mswietlicki/jaskier_door_lock_ex/hardware/door-lock-c/docs/board-top.png

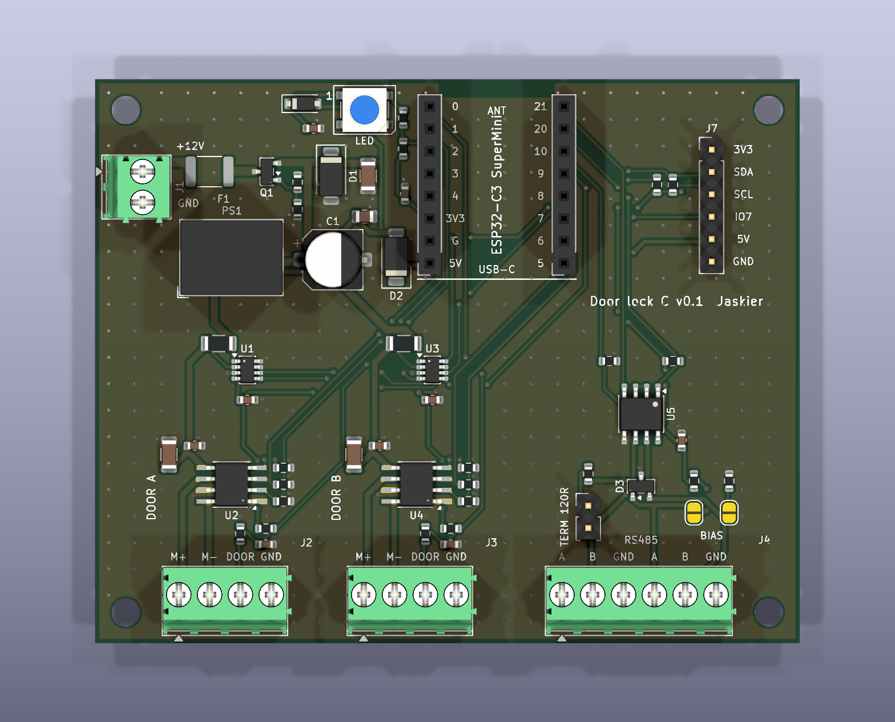
hardware/door-lock-c/docs/board-top.png
