mswietlicki/jaskier_door_lock_ex/hardware/door-lock-c/docs/case-base.png

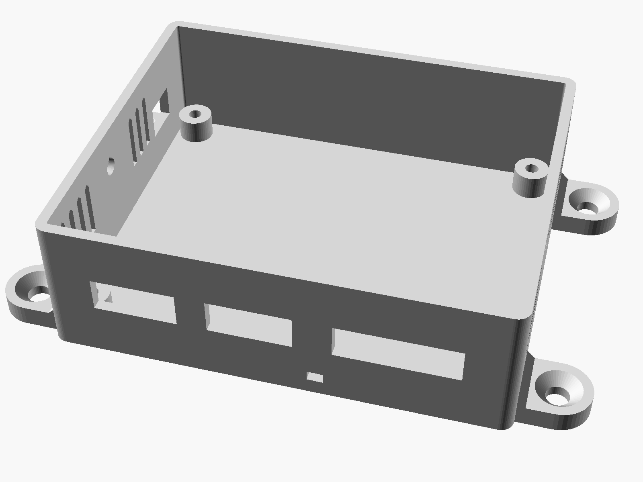
hardware/door-lock-c/docs/case-base.png
