mswietlicki/jaskier_door_lock_ex/hardware/door-lock-c/jlcpcb/lcsc-order.csv

LCSC Part Number | Quantity | Comment | Footprint | Per door-lock-c | Per CAN-B | Per RS485 tee | Needed (3 door-lock-c + 2 CAN-B + 10 RS485 tee)
C72478 | 4 | 100u 35V | CP_Elec_6.3x7.7 | 1 | 0 | 0 | 3
C1591 | 40 | 100n 50V X7R (Samsung CL10B104KB8NNNC, for C14663: 50 at LCSC on 5 Nov 2026) | C_0603_1608Metric | 9 | 3 | 0 | 33
C1589 | 4 | 10n 50V X7R (Samsung CL10B103KB8NNNC, for C57112: 0 at LCSC on 5 Nov 2026) | C_0603_1608Metric | 0 | 1 | 0 | 2
C15850 | 7 | 10u 25V | C_0805_2012Metric | 1 | 1 | 0 | 5
C13585 | 14 | 10u 50V | C_1206_3216Metric | 3 | 1 | 0 | 11
C2992390 | 6 | K7805-500R3 | Converter_DCDC_RECOM_R-78E-0.5_THT | 1 | 1 | 0 | 5
C364288 | 4 | SMAJ16A | D_SMA | 1 | 0 | 0 | 3
C41376408 | 3 | SMAJ20A | D_SMA | 0 | 1 | 0 | 2
C8678 | 8 | SS34 | D_SMA | 1 | 2 | 0 | 7
C81598 | 4 | 1N4148W | D_SOD-123 | 1 | 0 | 0 | 3
C12559 | 3 | 0.5A 30V | Fuse_1812_4532Metric | 0 | 1 | 0 | 2
C883149 | 4 | 1.1A 24V | Fuse_1812_4532Metric | 1 | 0 | 0 | 3
C2986059 | 4 | green | LED_0603_1608Metric | 0 | 1 | 0 | 2
C2843785 | 4 | XL-5050RGBC-2812B | LED_WS2812B_PLCC4_5.0x5.0mm_P3.2mm | 1 | 0 | 0 | 3
C100114 | 14 | Jumper cap 2.54 mm, closed (TERM 120R) | P=2.54mm | 1 | 0 | 1 | 13
C492401 | 14 | TERM 120R jumper | PinHeader_1x02_P2.54mm_Vertical | 1 | 0 | 1 | 13
C492405 | 6 | Extension | PinHeader_1x06_P2.54mm_Vertical | 1 | 1 | 0 | 5
C27438 | 11 | 1x8 female 2.54 mm, 8.5 mm | PinSocket_1x08_P2.54mm_Vertical | 2 | 2 | 0 | 10
C22775 | 5 | 100 | R_0603_1608Metric | 1 | 0 | 0 | 3
C25803 | 8 | 100k | R_0603_1608Metric | 2 | 0 | 0 | 6
C25804 | 21 | 10k | R_0603_1608Metric | 5 | 1 | 0 | 17
C22787 | 16 | 120 | R_0603_1608Metric | 1 | 0 | 1 | 13
C22807 | 4 | 150k | R_0603_1608Metric | 0 | 1 | 0 | 2
C22935 | 4 | 1M | R_0603_1608Metric | 0 | 1 | 0 | 2
C21190 | 10 | 1k | R_0603_1608Metric | 2 | 1 | 0 | 8
C23162 | 29 | 4.7k | R_0603_1608Metric | 6 | 3 | 0 | 24
C23189 | 6 | 5.6k | R_0603_1608Metric | 0 | 2 | 0 | 4
C23206 | 8 | 56k | R_0603_1608Metric | 2 | 0 | 0 | 6
C23228 | 8 | 680 | R_0603_1608Metric | 2 | 0 | 0 | 6
C25334 | 8 | 0.1 | R_1206_3216Metric | 2 | 0 | 0 | 6
C2671216 | 3 | TJA1055T/3 | SOIC-14_3.9x8.7mm_P1.27mm | 0 | 1 | 0 | 2
C8963 | 4 | SP3485EN | SOIC-8_3.9x4.9mm_P1.27mm | 1 | 0 | 0 | 3
C15127 | 4 | AO3401A | SOT-23 | 1 | 0 | 0 | 3
C172881 | 4 | SM712 | SOT-23 | 1 | 0 | 0 | 3
C87469 | 7 | INA219AIDCNR | SOT-23-8 | 2 | 0 | 0 | 6
C466970 | 4 | Power: +12V GND | TerminalBlock_Phoenix_PT-1,5-2-3.5-H_1x02_P3.50mm_Horizontal | 1 | 0 | 0 | 3
C466971 | 31 | Screw terminal 3P 3.5 mm | TerminalBlock_Phoenix_PT-1,5-3-3.5-H_1x03_P3.50mm_Horizontal | 0 | 0 | 3 | 30
C2757925 | 7 | Door A: M+ M- DOOR GND | TerminalBlock_Phoenix_PT-1,5-4-3.5-H_1x04_P3.50mm_Horizontal | 2 | 0 | 0 | 6
C3646874 | 3 | Van: +12V GND VCAR CANH CANL | TerminalBlock_Phoenix_PT-1,5-5-3.5-H_1x05_P3.50mm_Horizontal | 0 | 1 | 0 | 2
C5290323 | 4 | RS485: A B GND A B GND | TerminalBlock_Phoenix_PT-1,5-6-3.5-H_1x06_P3.50mm_Horizontal | 1 | 0 | 0 | 3
C75864 | 7 | DRV8871DDAR | Texas_HTSOP-8-1EP_3.9x4.9mm_P1.27mm_EP2.95x4.9mm_Mask2.4x3.1mm_ThermalVias | 2 | 0 | 0 | 6
