mswietlicki/jaskier_door_lock_ex/hardware/door-lock-c/case/stl/door-lock-c-case-base.stl

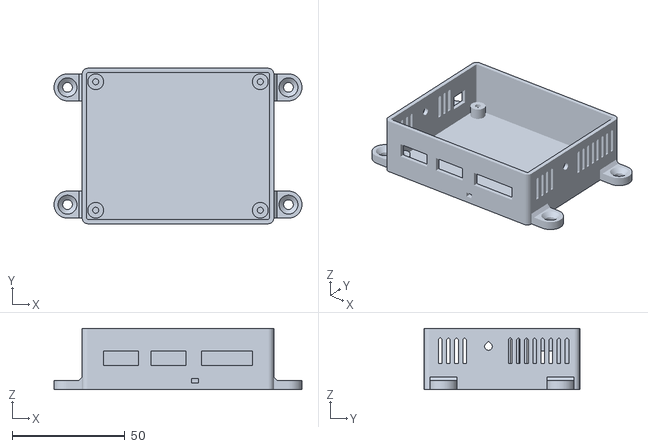
[picture p9: CAD file, 2026-11-06]
hardware/door-lock-c/case/stl/door-lock-c-case-base.stl
110.0 x 69.0 x 27.1
