mswietlicki/jaskier_door_lock_ex/hardware/door-lock-c/case/stl/door-lock-c-case-lid.stl

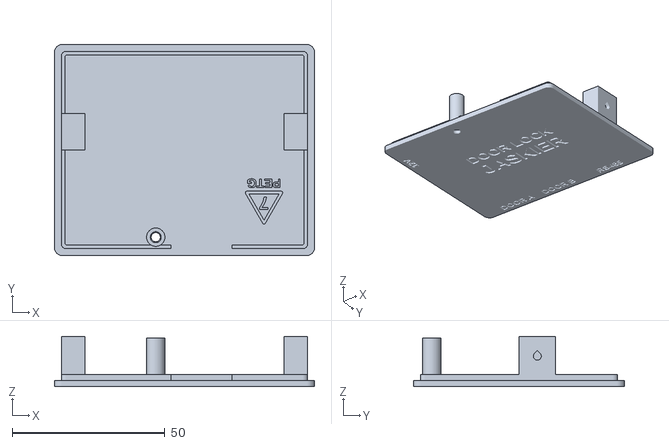
[picture p10: CAD file, 2026-11-06]
hardware/door-lock-c/case/stl/door-lock-c-case-lid.stl
85.0 x 69.0 x 16.5
