mswietlicki/jaskier_door_lock_ex/docs/wiring_b.html

Bench build · perfboard prototype · variant B

# Four-Door 12 V Actuator Lock Controller

One ESP32-S3-DevKitC-1 running ESPHome drives four fully independent door locks from one board: four DRV8871 H-bridges, four INA219 high-side current monitors on a shared I²C bus, one MH-MINI-360 buck, one 4S LiFePO4 pack. Per door, the circuit and the firmware are identical to variant A — end of travel and obstructions are both read out of the motor current, no extra sensors.

This document covers variant B (door_lock_b.yaml). The single-door build is documented in wiring.html; everything said there about the current path, star grounds and threshold tuning applies here to each of the four branches.

Pack

4S LiFePO₄ · 10.0–14.6 V

Doors

4 · fully independent

Shunts

4 × 0.1 Ω INA219

I²C

GPIO8 / GPIO9 · 0x40 41 44 45

Bridges

4 × DRV8871 · no PWM

Fuse

5 A slow-blow

## Read this before you power anything U4

Set the buck output first

The MH-MINI-360 ships with its trimpot in an arbitrary position and will happily pass something close to 12 V straight through. The DevKitC-1's 5V pin feeds its on-board regulator and USB rail — anything well above 5 V destroys it.

Wire U4 to the pack with nothing on its output, measure OUT+ to OUT− with a meter, turn the trimpot until it reads 5.00 V, then power down and connect U1.

Two things a door lock has to get right — times four

Every one of the four doors keeps a mechanical override — a key cylinder or a thumb turn — that works with the electronics dead. And no actuator may trap anyone inside; each bolt must be releasable from the protected side without power.

Two design consequences worth flagging up front. First, the firmware drives every bridge fully on, never PWM — PWM would chop the current the INA219s see and make stall detection unreliable. Second, the doors are fully independent and can all move at once: four actuators stalling together draw around 2 A plus inrush, which is why F1 is 5 A here rather than variant A's 2 A, and why every 12 V run is sized for the sum, not one motor.

## Wiring diagram Figure B1

+12 V (fused, from pack) +5 V (buck output) +3.3 V (U1 regulator) GND / return I²C (shared bus, ×4) Bridge control (3.3 V logic) Motor leads ● Junction — connected ╫ Crossing without ● — not connected □ Hollow pad — optional / no connection ◆ On-board WS2812 status LED

Four copies of variant A's current path off one spine. Pack → F1 → +12 V rail → each door's 0.1 Ω shunt → its bridge → its motor. Door 1 is drawn with the detail annotations (truth table, pull-down note); doors 2–4 are wired identically and differ only in the two ESP pins and the INA219 address printed above each branch. At every bridge: the upper green wire is IN1 (unlock), the two 10 k pull-downs hold it off through reset, and C1 100 µF + C2 100 nF (not drawn, see net list) sit across Power ±. ESP pins are drawn in logical positions — the physical J1/J3 header order is in the pinout table.

## Net list

Shared spine first, then one block per door — build and test door by door. Everything in the 12 V group carries motor current: keep it short, thick, and away from the I²C pair. n stands for the door letter a–d.

Net | From | To | Wire | Notes
+12V_BAT | BAT1 + | F1 | 16 AWG | Screw terminal at the board edge. F1 = 5 A: the rail feeds four motors
+12V_BAT | F1 | D1 anode | 16 AWG | D1 optional; omit and the polarity is on you
+12V | D1 cathode | +12 V rail | 16 AWG | Rail = a length of bare 16 AWG along the board, all four branches tap it
+12V | +12 V rail | U4 IN+ | 22 AWG | Logic supply branch
+5V | U4 OUT+ | U1 5V | 24 AWG | Verify 5.00 V before connecting
+3V3 | U1 3V3 | U3a–d VCC | 26 AWG | One feed, daisy-chained across the four modules is fine (mA load)
SDA | U1 IO8 | U3a–d SDA | 26 AWG | One shared bus. Keep the whole run < 25 cm, away from motor leads
SCL | U1 IO9 | U3a–d SCL | 26 AWG | Four modules = four 10 k pull-ups in parallel ≈ 2.5 k — fine at 400 kHz, add nothing
Per door n = a–d — repeat the following block four times
+12V | +12 V rail | U3n VIN+ | 20 AWG | This door's motor branch enters its shunt here. Big pad
VMn | U3n VIN− | U2n Power + | 20 AWG | Shunt output — the only path to this door's bridge. Big pad
Mn+ | U2n Motor + | Mn lead A | 20 AWG | Twist the pair; swap A/B if travel is inverted
Mn− | U2n Motor − | Mn lead B | 20 AWG | C3 100 nF across the two, at the motor end
IN1 | U1 (pin table) | U2n IN1 | 26 AWG | High = drive towards UNLOCKED. 10 k to GND at U2n's header
IN2 | U1 (pin table) | U2n IN2 | 26 AWG | High = drive towards LOCKED. 10 k to GND — holds the bridge off while U1 resets
C1, C2 | U2n Power + | U2n Power − | — | 100 µF / 25 V electrolytic + 100 nF ceramic, at every bridge's terminals
GND | U2n Power − | GND rail | 20 AWG | This door's motor return; own wire straight to the star
GND | U3n GND | GND rail | 24 AWG | Own wire — this is the door's measurement reference
GND | BAT1 − | GND rail | 16 AWG | This point is the star — nothing daisy-chains past it
GND | U4 IN− and OUT− | GND rail | 22 AWG | Both pads, joined at the board
GND | U1 GND | GND rail | 24 AWG | Own wire — do not share with any motor return

Never bridge a shunt — now four chances to get it wrong

Every INA219 brings VIN+ and VIN− out twice — as large pads for load current and again on the 6-way header. Each pair is the same copper, with a single 0.1 Ω shunt between them. Wire the big pair only and leave the header pins empty, on all four modules.

Land two wires from the same side of the circuit on both footprints and you short across that shunt. The motor still runs normally, so nothing looks broken — but that door's current reads ≈ 0 A forever, every move ends instantly as "current collapsed", and its jam detection never fires. Before wiring each module, check with a meter: VIN+ to VIN− about 0.1 Ω, big-to-small on the same name about 0 Ω.

Address jumpers — set before soldering into the board

The A1/A0 solder jumpers on each INA219 tie the address pins to VCC. Set them per the table below and label each module — a swapped pair means two doors report each other's current, and every symptom will point somewhere else.

Door | Module | A1 | A0 | Address | IN1 / IN2
1 | U3a | open | open | 0x40 | IO4 / IO5
2 | U3b | open | bridged | 0x41 | IO6 / IO7
3 | U3c | bridged | open | 0x44 | IO15 / IO16
4 | U3d | bridged | bridged | 0x45 | IO17 / IO18

## Pinouts, in full

### U1 — ESP32-S3-DevKitC-1

Two 22-pin headers at 2.54 mm. The table below lists them in physical order, top to bottom, USB-C connectors uppermost — this is where Figure B1's "logical" pin positions actually land. Verify against your board's silkscreen: clones exist and revisions differ.

J1 (left) | Wired to | Constraints worth knowing
3V3 | U3a–d VCC | Regulator output. Four INA219s draw ~4 mA total — nothing.
3V3 | free | Second 3V3 pin, same net.
RST | free | Reset, active low.
GPIO4 | U2a IN1 | Plain GPIO. Door 1 unlock.
GPIO5 | U2a IN2 | Plain GPIO. Door 1 lock.
GPIO6 | U2b IN1 | Door 2 unlock.
GPIO7 | U2b IN2 | Door 2 lock.
GPIO15 | U2c IN1 | Door 3 unlock. 32 kHz XTAL pin on some designs — not fitted here, plain GPIO.
GPIO16 | U2c IN2 | Door 3 lock.
GPIO17 | U2d IN1 | Door 4 unlock.
GPIO18 | U2d IN2 | Door 4 lock.
GPIO8 | U3a–d SDA | Shared I²C data.
GPIO3 | free | Strapping pin (JTAG source). Leave floating.
GPIO46 | free | Strapping pin — must not be high at boot. Leave open.
GPIO9 | U3a–d SCL | Shared I²C clock.
GPIO10 | SW-L1 (optional) | Door 1 bolt-locked switch.
GPIO11 | SW-U1 (optional) | Door 1 bolt-unlocked switch.
GPIO12 | SW-L2 (optional) | Door 2 bolt-locked switch.
GPIO13 | SW-U2 (optional) | Door 2 bolt-unlocked switch.
GPIO14 | SW-L3 (optional) | Door 3 bolt-locked switch.
5V | U4 OUT+ | Set the buck to 5.00 V first. Feeds the on-board regulator.
GND | GND rail | Own wire to the star.

J3 (right) | Wired to | Constraints worth knowing
GND | — | Same net as J1's GND.
TX (GPIO43) | free | UART0. Free because logging goes over USB.
RX (GPIO44) | free | UART0.
GPIO1 | SW-L4 (optional) | Door 4 bolt-locked switch. ADC1_CH0.
GPIO2 | SW-U4 (optional) | Door 4 bolt-unlocked switch. ADC1_CH1.
GPIO42 | BTN4 (optional) | Door 4 button. JTAG MTMS by default — fine as GPIO.
GPIO41 | BTN3 (optional) | Door 3 button. JTAG MTDI.
GPIO40 | BTN2 (optional) | Door 2 button. JTAG MTDO.
GPIO39 | BTN1 (optional) | Door 1 button. JTAG MTCK.
GPIO38 | free | On v1.1 boards this is the on-board WS2812 — change pin_rgb to GPIO38 there.
GPIO37 | reserved | SPIIO7 — used by octal PSRAM on R8 modules. Do not wire.
GPIO36 | reserved | SPIIO6 — same.
GPIO35 | reserved | SPIIO5 — same.
GPIO0 | free | Strapping pin (BOOT button). Leave open.
GPIO45 | free | Strapping pin (VDD_SPI voltage). Leave open.
GPIO48 | on-board WS2812 | Status LED on v1.0 boards, no external wiring.
GPIO47 | free | —
GPIO21 | SW-U3 (optional) | Door 3 bolt-unlocked switch.
GPIO20 | reserved | USB D+. Leave open or you lose USB flashing and logging.
GPIO19 | reserved | USB D−.
GND | — | —
GND | — | —

### U2a–d — DRV8871 breakout (Adafruit 3190), one per door

Terminal | Type | Wired to | Notes
Power + | screw | own U3n VIN− | 6.5–45 V. Same net as the header's VM pin.
Power − | screw | GND rail | Own return wire per bridge, straight to the star.
Motor + | screw | Mn lead A | OUT1
Motor − | screw | Mn lead B | OUT2
VM | header | unused | Duplicate of Power +. Use one or the other.
IN1 | header | U1 (pin table) | 1.5 V logic threshold — 3.3 V drive is fine. 10 k to GND.
IN2 | header | U1 (pin table) | 10 k to GND.
GND | header | unused | Duplicate of Power −.
RILIM | on-board SMD | — | Chip's own trip ≈ 2 A. Leave it: the firmware limit does the real work at 0.5 A per door.

### U3a–d — INA219 modules, 0.1 Ω shunt, one per door

Pin | Wired to | Notes
VCC | U1 3V3 | 3.0–5.5 V. All four share the one 3V3 feed.
GND | GND rail (own wire each) | Measurement reference. Four separate wires to the star, never through a motor return.
SCL | U1 GPIO9 | Shared bus. 4 × 10 k module pull-ups ≈ 2.5 k combined — do not add more.
SDA | U1 GPIO8 | Shared bus.
VIN+ | +12 V rail | High side of this door's shunt. Big pad, not the header pin.
VIN− | own U2n Power + | Low side, and the bus-voltage sense node. Big pad.
VIN+ / VIN− (header) | leave empty | Duplicates — same copper. Populate one pair only, on every module.
A0 / A1 | per address table | 0x40 / 0x41 / 0x44 / 0x45 — set and label before soldering in.

### U4 — MH-MINI-360 (MP1584EN)

Pad | Wired to | Notes
IN+ | +12 V rail | 4.75–23 V. A 4S LiFePO₄ pack at 14.6 V is well inside range.
IN− | GND rail | —
OUT+ | U1 5V | Set to 5.00 V with the trimpot before connecting U1. The S3 + four INA219s draw well under its 1.8 A.
OUT− | GND rail | —
trimpot | — | Multi-turn; clockwise usually raises output. Measure, don't guess.

## Optional position feedback, per door Figure B2

The firmware works without these — each door's state survives a reboot in flash. But flash-restored state is a belief, not a measurement: if someone moves a bolt by hand while the board is off, it will be wrong. Two reed or micro switches per door turn that belief into a fact, and a push-button gives each door a local toggle.

Fit them, then enable them — per door. Each door has its own Use position switches entity in Home Assistant; turn one on only once that door's SW-L and SW-U are actually installed. With it on, a closed switch ends that door's move immediately and overrides the current-based verdict. For leads longer than about 30 cm add a 100 nF cap from each pin to GND at the ESP32 end.

Door | SW-L (bolt locked) | SW-U (bolt unlocked) | BTN (toggle)
1 | GPIO10 | GPIO11 | GPIO39
2 | GPIO12 | GPIO13 | GPIO40
3 | GPIO14 | GPIO21 | GPIO41
4 | GPIO1 | GPIO2 | GPIO42

## How a move ends Figure B3

Every move is a race between four outcomes. The firmware samples the INA219 at 20 Hz, ignores the first 400 ms of inrush, then needs three consecutive samples past a threshold before it commits — one noisy reading never triggers anything.

The only thing separating ② from ③ is the clock. A stall after min travel time is the bolt arriving; the same stall before it is an obstruction. That one threshold is what you tune first, and it is why min travel time must be set from a measured stroke rather than guessed. Panels ③ and ④ also fire a esphome.door_lock_fault event and set the lock entity to Jammed. A fifth path exists but isn't drawn: after inrush blanking, current above the hard current limit aborts on the first sample, with no debounce. Three invalid current samples latch a sensor fault without attempting back-off.

## Perfboard layout

The schematic is drawn as a fused +12 V spine with four identical branches because that is how it should be built: a bare 16 AWG +12 V rail along one edge, a bare 16 AWG GND rail along the other, the ESP in the middle, and the four shunt-bridge pairs in a row between them. Beyond variant A's rules (all of which still apply):

- Keep each door's branch together. U3n → U2n → motor terminals should sit next to each other, one column per door. Never route one door's motor pair past another door's INA219.
- C1 and C2 at every bridge's power terminals — four sets, not one shared set at the battery. Four motors switching on the same rail is exactly the brown-out scenario they exist for.
- Star the grounds — ten returns. BAT1 − is the star: four bridge motor returns, four INA219 references, U4, and U1 each land on the rail with their own wire. A shared return between a bridge and an INA219 corrupts that door's current reading; a shared return between two bridges couples the doors' noise.
- One I²C bus, kept short. Chain SDA/SCL along the four modules on the side of the board away from the motor wiring, whole run under ~25 cm. Four modules put four 10 k pull-ups in parallel (≈ 2.5 k effective) — that is comfortably strong at 400 kHz; do not add the extra 4.7 k resistors from the variant A notes.
- Screw terminals for everything leaving the board — pack and all four motors. Ten flying leads soldered to perfboard will not survive four slamming doors.
- Fuse for the sum. F1 is 5 A because all four doors may legitimately move at once (~2 A steady plus four inrush spikes). It still protects the board: a 4S LiFePO₄ pack delivers tens of amps into a fault without noticing.

## Bill of materials

Ref | Qty | Part | Spec | Notes
U1 | 1 | ESP32-S3-DevKitC-1 | ESP32-S3-WROOM-1, N8R2 or N16R8 | Any flash size works. Note the board revision — it moves the RGB LED pin.
U2a–d | 4 | Adafruit DRV8871 breakout | 6.5–45 V, 2 A / 3.6 A pk | One per door
U3a–d | 4 | INA219 module | 0.1 Ω, ±3.2 A | Set A1/A0 jumpers to 0x40/0x41/0x44/0x45 and label each
U4 | 1 | MH-MINI-360 | MP1584EN, 1.8 A | Buy two; the trimpots are fragile
M1–4 | 4 | 12 V linear actuator | stall ≈ 0.5 A measured | Doors may use different models — thresholds are per door
BAT1 | 1 | LiFePO₄ 4S pack | 12.8 V nom, BMS | BMS must sustain ~3 A bursts
F1 | 1 | Fuse + holder | 5 A slow-blow | Sized for four simultaneous moves; or a 4 A polyfuse
D1 | 1 | Schottky diode | SS54 / 1N5822 | Optional reverse-polarity protection; 5 A rated, ~0.4 V drop
C1a–d | 4 | Electrolytic | 100 µF / 25 V | One at every bridge; 35 V if the pack ever sees a charger
C2a–d, C3a–d | 8 | Ceramic | 100 nF / 50 V | C2 at each bridge, C3 across each motor
R1–R8 | 8 | Resistor | 10 kΩ ¼ W | IN1/IN2 pull-downs, two per bridge
SW-L1–4, SW-U1–4 | 8 | Reed or micro switch | NO, dry contact | Optional position feedback, two per door
BTN1–4 | 4 | Momentary push-button | NO | Optional local toggle, one per door

## Commissioning

The board comes up once; the doors are commissioned one at a time with the other three motors unplugged. Steps 1–5 happen with all motors disconnected.

1. Set the buck. U4 on the pack, nothing on its output, meter on OUT+/OUT−, trim to 5.00 V. Power down.
2. Set and label the INA219 addresses. Bridge the A1/A0 jumpers per the address table before soldering the modules in, and mark each module with its door number.
3. Bring up U1 alone. Flash door_lock_b.yaml over USB-C, then power it from U4 and confirm it joins Wi-Fi and Home Assistant.
4. Confirm I²C. The boot log must print four lines: Found i2c device at address 0x40, 0x41, 0x44, 0x45. A missing address is a jumper problem; solve it before going further.
5. Check each sense path. With motors unplugged but the 12 V branches live, every door's supply-side reading should behave: the shared supply voltage shows pack voltage, and each Door n motor current reads a few milliamps. A door stuck at a dead flat 0.000 A has a bridged shunt — measure 0.1 Ω across that module's VIN+/VIN− with power off.
6. Per door, in turn — connect only that door's motor, then run variant A's sequence with that door's entities: verify direction with Door n jog unlock (swap the motor leads at U2n if inverted), measure free-running and stall currents, set the six Door n thresholds, measure the stroke and set min/max travel, and test the jam path with something soft.
7. All together. Reconnect everything and command all four doors at once (this is what your future "close all" does). Watch supply voltage sag and confirm no door false-jams from the shared-rail dip. If one does, its stall threshold is too tight.

### Setting the thresholds

Same six knobs as variant A, but per door — 24 number entities in all, each stored in flash. Doors with different actuators, stroke lengths, or friction will end up with different values; that is the point. The variant A guidance applies verbatim to each door:

Entity (× 4 doors) | Default | How to pick it
Door n idle current | 0.01 A | Well below the commissioned 0.04–0.06 A free-running current, above the ≈0.003 A standing reading.
Door n stall current | 0.40 A | Roughly midway between this door's free-running and stall.
Door n hard current limit | 0.60 A | Just above this door's stall. After blanking: single sample, no debounce.
Door n inrush blanking | 400 ms | Long enough to cover this actuator's startup spike.
Door n min travel time | 1500 ms | ≈ 70 % of this door's measured full stroke.
Door n max travel time | 4500 ms | Commissioned stroke plus cold-weather margin.

If a door's free-running current is close to its stall current

Same escape hatch as variant A, per door: fit that door's SW-L/SW-U from Figure B2, turn on its Use position switches entity, and let the switches call end-of-travel while current detection stays as the jam guard. The other doors are unaffected.

## What Home Assistant gets

Everything from variant A, four times over, prefixed Door 1 … Door 4 — plus one shared supply voltage sensor (all four INA219s sit on the same rail, so it is read from door 1's). Per door: the lock entity, motor current, last-move peak/duration, fault, last result, stop / clear-fault / jog buttons, the position-switch toggle, and six thresholds.

The single on-board LED is an aggregate: red = any door's fault latched · white = any door moving · green flash = a move just finished · off = all quiet.

### One automation for all four doors

The fault event carries a door field, so one hook covers everything:

automation:
  - alias: Any door lock fault
    trigger:
      - platform: event
        event_type: esphome.door_lock_fault
    action:
      - service: notify.mobile_app_phone
        data:
          title: "{{ trigger.event.data.door }}: {{ trigger.event.data.reason }}"
          message: >-
            While {{ trigger.event.data.direction }} —
            {{ trigger.event.data.peak_current }} A after
            {{ trigger.event.data.travel_ms }} ms

### "Close all" is just four service calls

The doors never wait on each other, so a close-all (or open-all) is a plain Home Assistant script — no firmware support needed:

script:
  close_all_doors:
    sequence:
      - service: lock.lock
        target:
          entity_id:
            - lock.door_locks_door_1
            - lock.door_locks_door_2
            - lock.door_locks_door_3
            - lock.door_locks_door_4

## Firmware notes

The config lives in door_lock_b.yaml; copy secrets.yaml.example to secrets.yaml and fill it in first. All of variant A's firmware decisions carry over unchanged (no PWM, coast between moves, internal 20 Hz current sampling, per-move watchdog, time-based back-off). What is specific to B:

- One copy of the logic. The whole per-door state machine lives in packages/door.yaml and is instantiated four times with per-door pins and addresses. Fix a bug once, all four doors get it.
- Doors share nothing at runtime. Each has its own globals, scripts, thresholds, fault latch and 500 ms watchdog. A jam on door 2 cannot stall or delay a move on door 3 — including the watchdog forcing one bridge off while another is mid-travel.
- The I²C bus is the only shared sensor path. Four INA219s at 50 ms each is a light load at 400 kHz; the state machines each run off their own internal fast sensor.
- The LED is advisory. It aggregates four doors into one pixel; the per-door truth is always the lock entity, the fault sensor and last result.

Sources: Espressif ESP32-S3-DevKitC-1 user guide (https://docs.espressif.com/projects/esp-dev-kits/en/latest/esp32s3/esp32-s3-devkitc-1/user_guide.html) · DRV8871 breakout (Botland) (https://botland.com.pl/sterowniki-silnikow-dc/7043-drv8871-jednokanalowy-sterownik-silnikow-45v36a-adafruit-3190-5904422335373.html) · INA219 module (Gotronik) (https://www.gotronik.pl/ina219-dwukierunkowy-czujnik-pradu-z-szyna-i2c-p-5736.html) · variant A build document (wiring.html)

The pinout tables assume the DevKitC-1 mounted with both USB-C connectors uppermost, J1 on the left. Header order differs between board revisions and clones — verify against the silkscreen before soldering, and check which pin your board's RGB LED uses (GPIO48 on v1.0, GPIO38 on v1.1).
