mswietlicki/jaskier_door_lock_ex/hardware/door-lock-c/docs/assembly-top.pdf

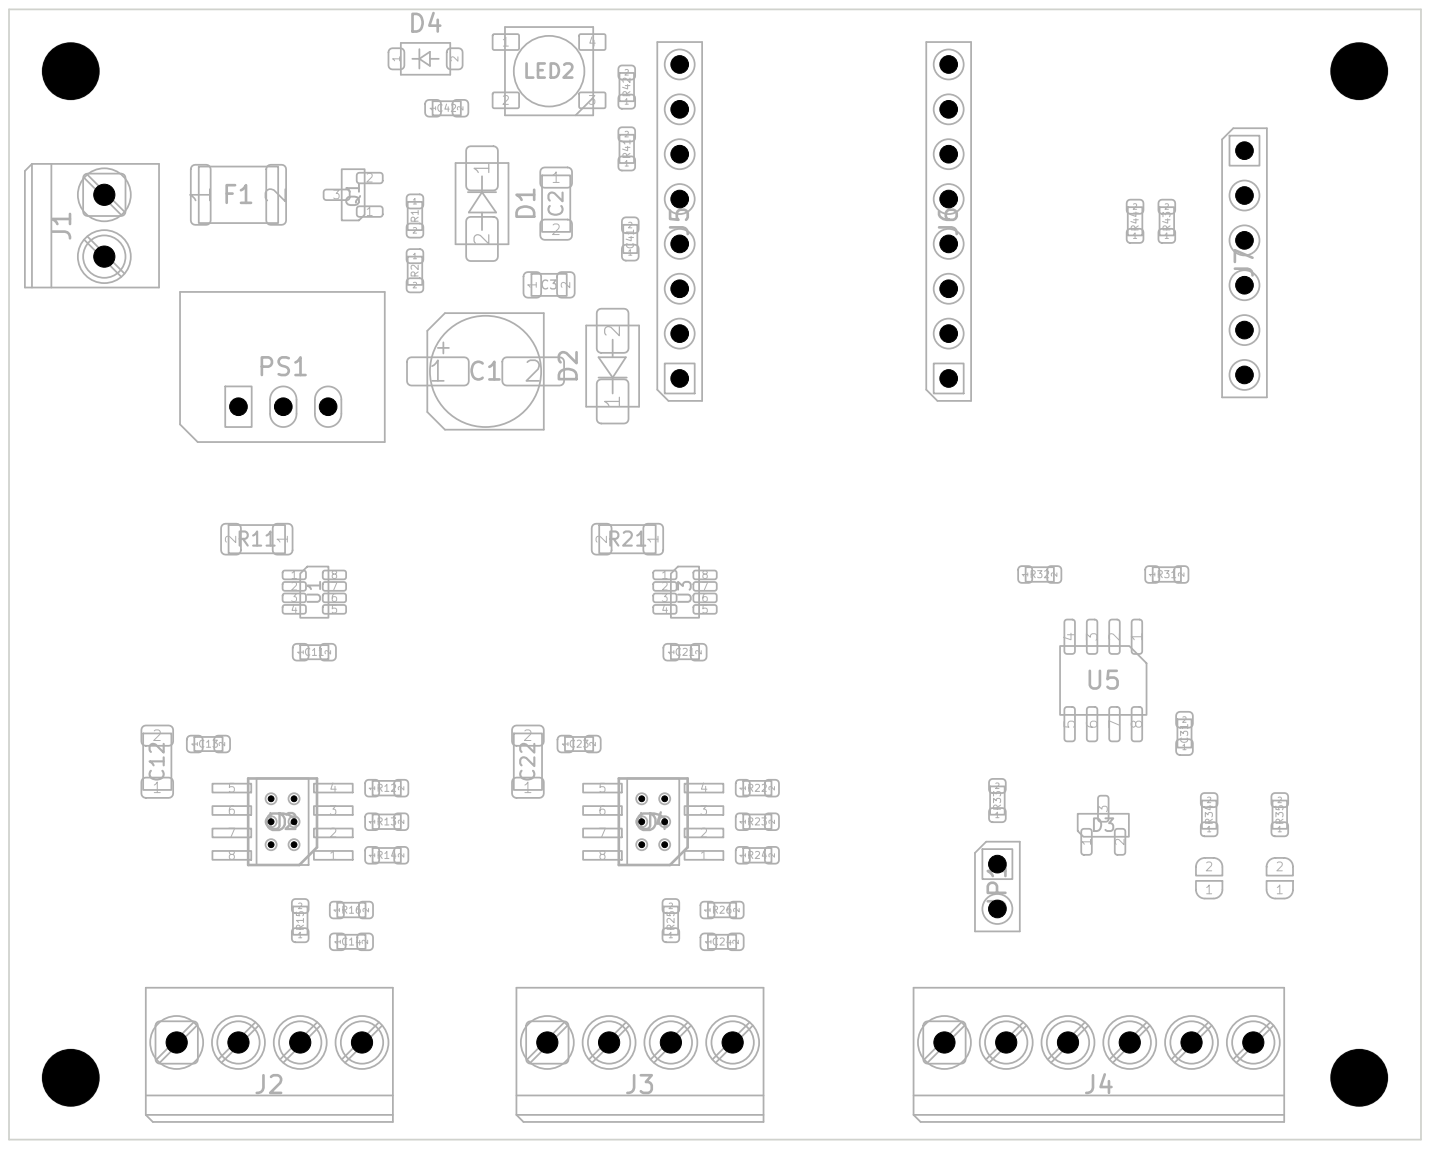
[picture p12: page 1]
