mswietlicki/jaskier_door_lock_ex/hardware/door-lock-c/door-lock-c.kicad_pcb

## KiCad design hardware/door-lock-c/door-lock-c.kicad_pcb (2026-11-05)

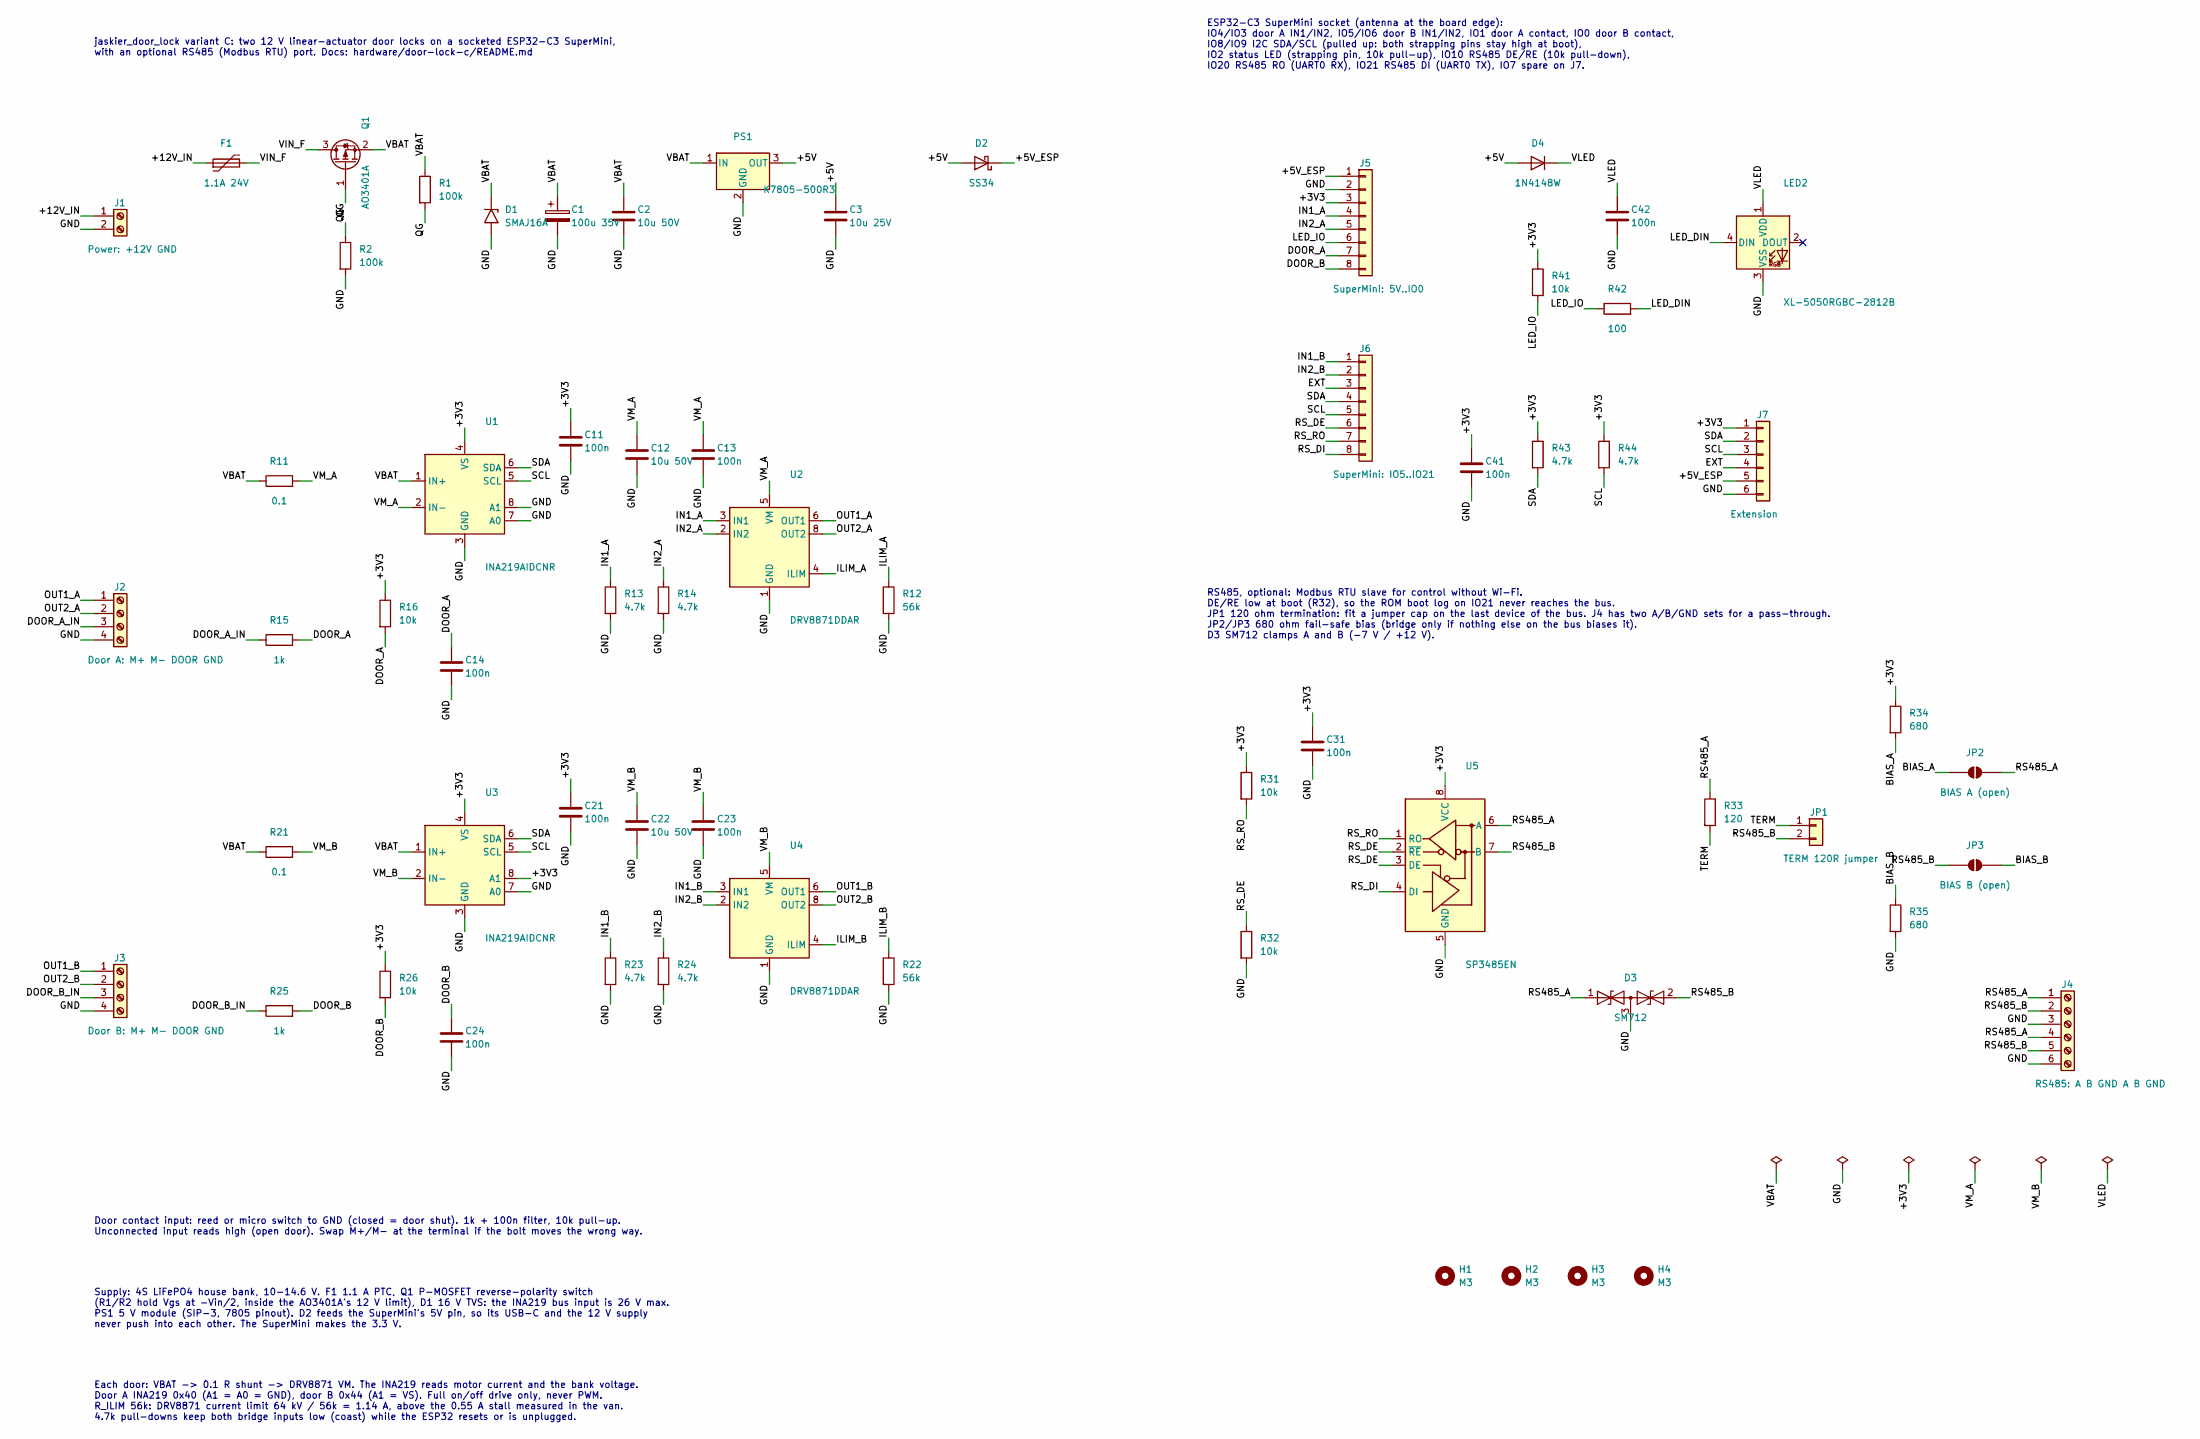
[picture p13: schematic door-lock-c.kicad_sch, Door lock C: two doors, ESP32-C3, RS485]

Parts:
C1: 100u 35V; CP_Elec_6.3x7.7; MPN ROQANG RVT1V101M0607; LCSC C72478
C2, C12, C22: 10u 50V; C_1206_3216Metric; LCSC C13585
C3: 10u 25V; C_0805_2012Metric; LCSC C15850
C11, C13, C14, C21, C23, C24, C31, C41, C42: 100n; C_0603_1608Metric; LCSC C14663
D1: SMAJ16A; D_SMA; LCSC C364288
D2: SS34; D_SMA; LCSC C8678
D3: SM712; SOT-23; MPN Littelfuse SM712-02HTG; LCSC C172881
D4: 1N4148W; D_SOD-123; LCSC C81598
F1: 1.1A 24V; Fuse_1812_4532Metric; MPN BHFUSE BSMD1812-110-24V (hold 1.1 A, tr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; LCSC C883149
H1, H2, H3, H4: M3; MountingHole_3.2mm_M3
J1: Power: +12V GND; TerminalBlock_Phoenix_PT-1,5-2-3.5-H_1x02_P3.50mm_Horizontal; MPN DORABO DB125-3.5-2P-GN-S; LCSC C466970
J2: Door A: M+ M- DOOR GND; TerminalBlock_Phoenix_PT-1,5-4-3.5-H_1x04_P3.50mm_Horizontal; MPN DORABO DB125-3.5-4P-GN-S; LCSC C2757925
J3: Door B: M+ M- DOOR GND; TerminalBlock_Phoenix_PT-1,5-4-3.5-H_1x04_P3.50mm_Horizontal; MPN DORABO DB125-3.5-4P-GN-S; LCSC C2757925
J4: RS485: A B GND A B GND; TerminalBlock_Phoenix_PT-1,5-6-3.5-H_1x06_P3.50mm_Horizontal; MPN DORABO DB125-3.5-6P-GN-S; LCSC C5290323
J5: SuperMini: 5V..IO0; PinSocket_1x08_P2.54mm_Vertical; MPN BOOMELE 2.54 1x8P female, 8.5 mm; LCSC C27438
J6: SuperMini: IO5..IO21; PinSocket_1x08_P2.54mm_Vertical; MPN BOOMELE 2.54 1x8P female, 8.5 mm; LCSC C27438
J7: Extension; PinHeader_1x06_P2.54mm_Vertical; MPN XFCN PZ254V-11-06P; LCSC C492405
JP1: TERM 120R jumper; PinHeader_1x02_P2.54mm_Vertical; MPN XFCN PZ254V-11-02P (cap: BOOMELE C10011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; LCSC C492401
JP2: BIAS A (open); SolderJumper-2_P1.3mm_Open_RoundedPad1.0x1.5mm
JP3: BIAS B (open); SolderJumper-2_P1.3mm_Open_RoundedPad1.0x1.5mm
LED2: XL-5050RGBC-2812B; LED_WS2812B_PLCC4_5.0x5.0mm_P3.2mm; MPN XINGLIGHT XL-5050RGBC-2812B; LCSC C2843785
PS1: K7805-500R3; Converter_DCDC_RECOM_R-78E-0.5_THT; MPN YLPTEC K7805-500R3 (6.5-36 V in, 5 V 0.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; LCSC C2992390
Q1: AO3401A; SOT-23; LCSC C15127
R1, R2: 100k; R_0603_1608Metric; LCSC C25803
R11, R21: 0.1; R_1206_3216Metric; LCSC C25334
R12, R22: 56k; R_0603_1608Metric; LCSC C23206
R13, R14, R23, R24, R43, R44: 4.7k; R_0603_1608Metric; LCSC C23162
R15, R25: 1k; R_0603_1608Metric; LCSC C21190
R16, R26, R31, R32, R41: 10k; R_0603_1608Metric; LCSC C25804
R33: 120; R_0603_1608Metric; LCSC C22787
R34, R35: 680; R_0603_1608Metric; LCSC C23228
R42: 100; R_0603_1608Metric; LCSC C22775
U1, U3: INA219AIDCNR; SOT-23-8; MPN TI INA219AIDCNR; LCSC C87469
U2, U4: DRV8871DDAR; Texas_HTSOP-8-1EP_3.9x4.9mm_P1.27mm_EP2.95x4.9mm_Mask2.4x3.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; MPN TI DRV8871DDAR; LCSC C75864
U5: SP3485EN; SOIC-8_3.9x4.9mm_P1.27mm; MPN MaxLinear SP3485EN-L/TR; LCSC C8963

Connections:
/+3V3: C11.1, C21.1, C31.1, C41.1, J5.3, J7.1, R16.1, R26.1, R31.1, R34.1, R41.1, R43.1, R44.1, U1.4 (VS), U3.4 (VS), U3.8 (A1), U5.8 (VCC)
/+5V: C3.1, D2.2 (A), D4.2 (A), PS1.3 (OUT)
/+5V_ESP: D2.1 (K), J5.1, J7.5
/+12V_IN: F1.1, J1.1
/BIAS_A: JP2.1 (A), R34.2
/BIAS_B: JP3.2 (B), R35.1
/DOOR_A: C14.1, J5.7, R15.2, R16.2
/DOOR_A_IN: J2.3, R15.1
/DOOR_B: C24.1, J5.8, R25.2, R26.2
/DOOR_B_IN: J3.3, R25.1
/EXT: J6.3, J7.4
/GND: C1.2, C2.2, C3.2, C11.2, C12.2, C13.2, C14.2, C21.2, C22.2, C23.2, C24.2, C31.2, C41.2, C42.2, D1.2 (A2), D3.3 (common), J1.2, J2.4, J3.4, J4.3, J4.6, J5.2, J7.6, LED2.3 (VSS), PS1.2 (GND), R2.2, R12.2, R13.2, R14.2, R22.2, R23.2, R24.2, R32.2, R35.2, U1.3 (GND), U1.7 (A0), U1.8 (A1), U2.1 (GND), U2.7 (GND), U2.9 (GND), U3.3 (GND), U3.7 (A0), U4.1 (GND), U4.7 (GND), U4.9 (GND), U5.5 (GND)
/ILIM_A: R12.1, U2.4 (ILIM)
/ILIM_B: R22.1, U4.4 (ILIM)
/IN1_A: J5.4, R13.1, U2.3 (IN1)
/IN1_B: J6.1, R23.1, U4.3 (IN1)
/IN2_A: J5.5, R14.1, U2.2 (IN2)
/IN2_B: J6.2, R24.1, U4.2 (IN2)
/LED_DIN: LED2.4 (DIN), R42.2
/LED_IO: J5.6, R41.2, R42.1
/OUT1_A: J2.1, U2.6 (OUT1)
/OUT1_B: J3.1, U4.6 (OUT1)
/OUT2_A: J2.2, U2.8 (OUT2)
/OUT2_B: J3.2, U4.8 (OUT2)
/QG: Q1.1 (G), R1.2, R2.1
/RS485_A: D3.1 (A1), J4.1, J4.4, JP2.2 (B), R33.1, U5.6 (A)
/RS485_B: D3.2 (A2), J4.2, J4.5, JP1.2, JP3.1 (A), U5.7 (B)
/RS_DE: J6.6, R32.1, U5.2 (~RE), U5.3 (DE)
/RS_DI: J6.8, U5.4 (DI)
/RS_RO: J6.7, R31.2, U5.1 (RO)
/SCL: J6.5, J7.3, R44.2, U1.5 (SCL), U3.5 (SCL)
/SDA: J6.4, J7.2, R43.2, U1.6 (SDA), U3.6 (SDA)
/TERM: JP1.1, R33.2
/VBAT: C1.1, C2.1, D1.1 (A1), PS1.1 (IN), Q1.2 (S), R1.1, R11.1, R21.1, U1.1 (IN+), U3.1 (IN+)
/VIN_F: F1.2, Q1.3 (D)
/VLED: C42.1, D4.1 (K), LED2.1 (VDD)
/VM_A: C12.1, C13.1, R11.2, U1.2 (IN-), U2.5 (VM)
/VM_B: C22.1, C23.1, R21.2, U3.2 (IN-), U4.5 (VM)

Notes on the sheet:
jaskier_door_lock variant C: two 12 V linear-actuator door locks on a socketed ESP32-C3 SuperMini, with an optional RS485 (Modbus RTU) port. Docs: hardware/door-lock-c/README.md
Supply: 4S LiFePO4 house bank, 10-14.6 V. F1 1.1 A PTC, Q1 P-MOSFET reverse-polarity switch (R1/R2 hold Vgs at -Vin/2, inside the AO3401A's 12 V limit), D1 16 V TVS: the INA219 bus input is 26 V max. PS1 5 V module (SIP-3, 7805 pinout). D2 feeds the SuperMini's 5V pin, so its USB-C and the 12 V sup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
Each door: VBAT -> 0.1 R shunt -> DRV8871 VM. The INA219 reads motor current and the bank voltage. Door A INA219 0x40 (A1 = A0 = GND), door B 0x44 (A1 = VS). Full on/off drive only, never PWM. R_ILIM 56k: DRV8871 current limit 64 kV / 56k = 1.14 A, above the 0.55 A stall measured in the van. 4.7k p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
Door contact input: reed or micro switch to GND (closed = door shut). 1k + 100n filter, 10k pull-up. Unconnected input reads high (open door). Swap M+/M- at the terminal if the bolt moves the wrong way.
ESP32-C3 SuperMini socket (antenna at the board edge): IO4/IO3 door A IN1/IN2, IO5/IO6 door B IN1/IN2, IO1 door A contact, IO0 door B contact, IO8/IO9 I2C SDA/SCL (pulled up: both strapping pins stay high at boot), IO2 status LED (strapping pin, 10k pull-up), IO10 RS485 DE/RE (10k pull-down), IO20 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
RS485, optional: Modbus RTU slave for control without Wi-Fi. DE/RE low at boot (R32), so the ROM boot log on IO21 never reaches the bus. JP1 120 ohm termination: fit a jumper cap on the last device of the bus. J4 has two A/B/GND sets for a pass-through. JP2/JP3 680 ohm fail-safe bias (bridge only i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

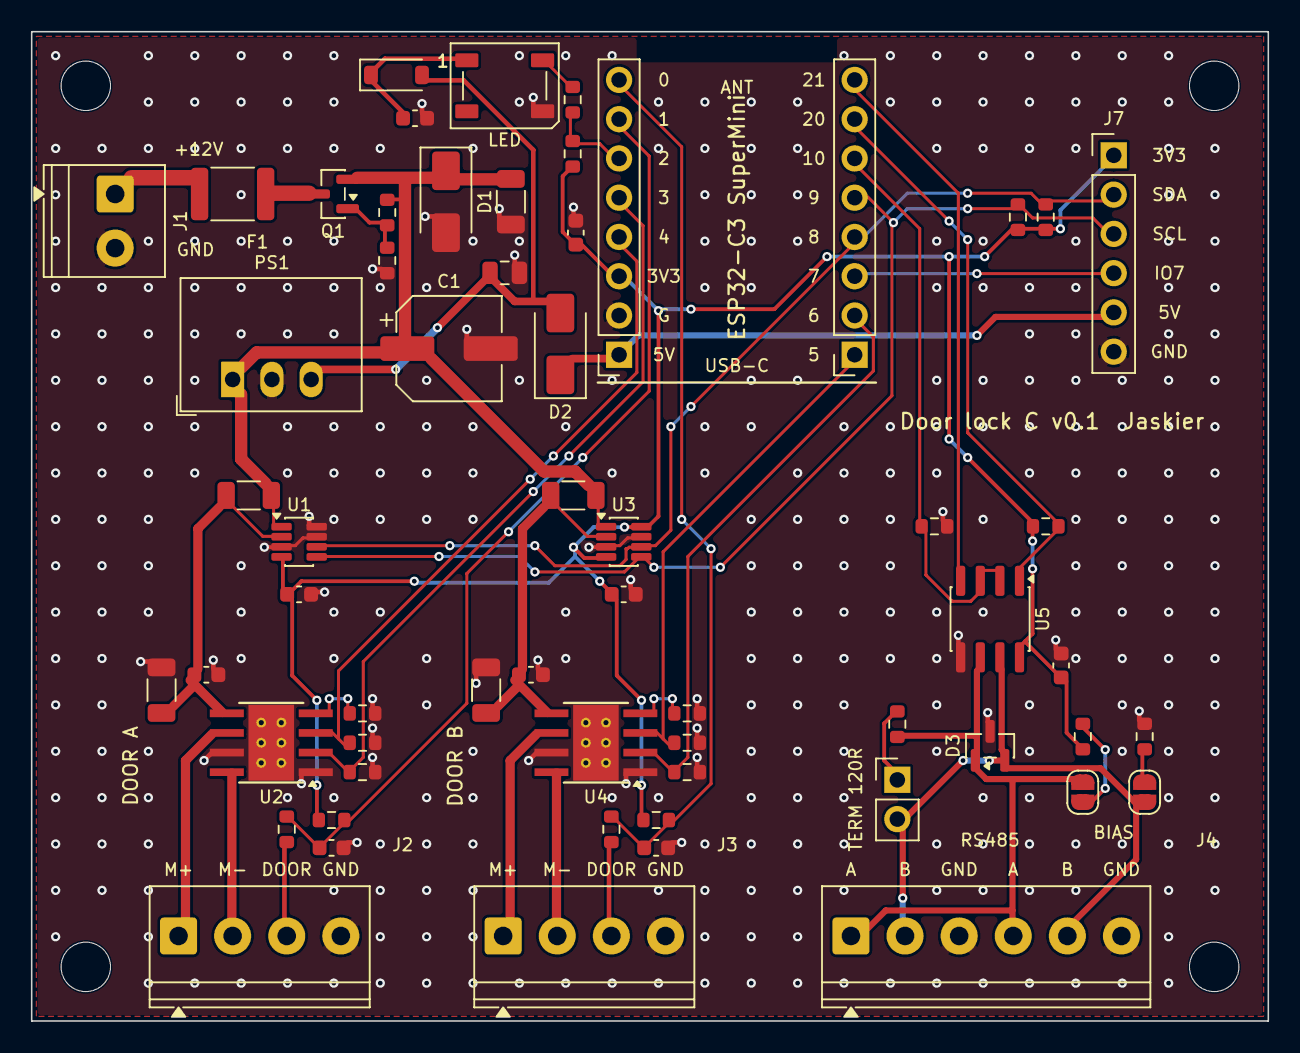
[picture p14: board door-lock-c.kicad_pcb from above]

Board: 2 copper layers, 80.0 x 64.0 mm, 64 parts (0 on the bottom side), 38 nets.
