mswietlicki/jaskier_door_lock_ex/(commit log)

2026-08-10 Fix ESPHome validation error on unnamed INA219 sub-sensors
    `shunt_voltage:` and `power:` were declared with only `internal: true`,
    which fails validation: a sub-sensor block needs an `id:` or a `name:`
    to identify the component. Setting `internal` alone gives the validator
    nothing to work with.
    Neither sensor is used by the firmware -- shunt voltage is just
    current x 0.1 ohm and power is current x bus voltage, both already
    derivable -- so they are dropped rather than given ids. An undeclared
    sub-sensor is simply not created, saving RAM and an API slot.
    Verified with `esphome config` against ESPHome 2026.7.4: the whole
    file now validates. Note this covers YAML schema only; lambdas are
    not c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
    [door_lock.yaml]
2026-08-10 Correct INA219 shunt terminal documentation
    The docs claimed all six INA219 pins sit on one 6-way header. In fact
    the module brings VIN+ and VIN- out twice: as large pads sized for load
    current, and again on the header. Each pair is the same copper with a
    single 0.1 ohm shunt between them.
    This mattered enough to fix loudly, because the failure mode is silent.
    Landing two wires from the same side of the circuit on both footprints
    shorts across the shunt. The motor still runs normally, so nothing looks
    broken -- but current reads ~0 A forever, every move terminates
    instantly as "current collapsed", and jam detection never fires at all.
    Since every safety decision in this design rests on that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
2026-08-16 Add ESP32-C3-Zero status LED diagnostics
2026-11-05 Add variant C: two-door board with door contacts and optional RS485
    KiCad 10 project for a hand-assembled JLCPCB board: two DRV8871 + INA219
    doors (0x40 / 0x44), a wired magnetic door contact input per door, a
    socketed ESP32-C3 SuperMini, and an SP3485 Modbus RTU port with a 6-pin
    pass-through terminal and a jumper header for the 120 ohm termination.
    Changes from the back door lock's readings (26 Oct - 5 Nov): DRV8871
    current limit 1.14 A (twice the measured 0.55 A stall), P-MOSFET reverse
    polarity so the INA219 reads the bank, 16 V TVS for the INA219's 26 V bus.
    Generated by tools/ (schematic from parts.py, placement and routing jobs
    in layout.py, a two-layer A* router). ERC 0, DRC 0, 0 u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
2026-11-05 Add the RS485 tee to the combined LCSC order
    tools/lcsc_order.py now merges three boards (door-lock-c, the CAN-B node
    and the RS485 tee from the jaskier repo) with --door, --canb and --tee;
    lcsc-order.csv is regenerated for 2 + 2 + 5 boards, with a jumper cap
    per TERM header.
2026-11-05 Add variant C firmware: two doors, door contacts, Modbus RTU on RS485
    door_lock_c.yaml runs the door-lock-c board: two doors on packages/door.yaml
    (INA219 0x40 / 0x44), a wired door contact per door, a WS2812 status LED,
    and a Modbus RTU server on UART0 (address 60, 9600 8N1, DE on IO10):
    coils 0/1 lock and unlock, registers 0-13 for commands, state, contact,
    fault, bank voltage and the last move. A lock command for an open door is
    refused. reboot_timeout 0s on wifi and api, so RS485 keeps working
    without Wi-Fi or Home Assistant.
    packages/door.yaml no longer carries the position switches and the local
    button: they move to packages/door_switches.yaml, which variant B now
    includes per door. d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
2026-11-05 Order for 3 door-lock-c, 2 CAN-B and 10 tees, with LCSC substitutions
    lcsc_order.py defaults to the real order (3 + 2 + 10) and buys
    equivalents where LCSC ran out on 5 Nov 2026: C1591 for the 100 nF
    (C14663, 50 left) and C1589 for CAN-B's 10 nF (C57112, none), both
    Samsung X7R 50 V 0603. lcsc-order.csv is regenerated (41 lines, all in
    stock). The README records how the list loads into LCSC's BOM tool and
    the two carts prepared that day (LCSC $91.32, JLCPCB EUR 48.37 with
    lead-free HASL and one stencil), not yet paid.
2026-11-05 door-lock-c: order record (JLCPCB W2026110603218840, LCSC WM2611060105)
    The cart estimates become the placed orders: the JLCPCB bare boards and
    stencil with prepaid customs ($90.56) and the LCSC parts by 4PX with the
    prepaid tariff ($133.22). Notes on the cancelled CAN-B assembly order and
    the Polish-shop comparison for the next reorder.
2026-11-06 door-lock-c: Door Lock Jaskier 3D-printed wall case
    Two-part PETG wall box, 85 x 69 x 29 mm, for the 80 x 64 mm board:
    base with 4 standoffs, countersunk wall holes under the board, cable
    windows for J1-J4 and a drain slot; lid held by 2 side M3 screws, with
    an LED tube and engraved labels ("DOOR LOCK" / "JASKIER", per-box line).
    OpenSCAD source, STLs in print orientation, renders, and case_fit.py,
    which checks the clearances against the KiCad 3D model (nothing touches).
2026-11-06 door-lock-c case: external screw ears, mount it closed
    Four countersunk ears on the side walls (4 mm, filleted, holes 6.5 mm
    from the wall for a screwdriver or bit holder), clear of the lid
    screws. The case now goes on the wall assembled and closed; the floor
    holes under the board are off by default (wall_screws). README:
    mounting order, ears, print estimate; renders updated. Fit check
    unchanged, nothing touches.
2026-11-06 door-lock-c case: PETG resin mark on base and lid
    ASTM D7611 triangle with code 7 and "PETG" (PETG is "other", not PET's
    1), engraved on the back of the base and inside the lid, reading the
    right way with the part turned over. resin_code / resin_abbr change or
    drop it. README: the mark, and the PrusaSlicer warnings that come from
    the text engraved in the bed faces. Fit check unchanged.
2026-11-06 door-lock-c case: cooling slits in the side walls
    19 slits, 1.6 x 11.5 mm, above the board and below the lid's lip: a
    low group on each side lets air in with the cable windows, a high group
    lets it out (3 on the left next to PS1, 8 on the right). Clear of the
    lid blocks and screws; none in the top wall, against dust and drips.
    Pointed ends toward the lid, so they print without bridges. README and
    renders updated; fit check unchanged, nothing touches.
